nlaczn2/build-a-burger/readme

final group chosen project using 3 arduinos

https://www.youtube.com/watch?v=rjfzDnm1CDM&t=5s
